KWB3/stm32-nrf24-transmitter/transmitter.jpeg

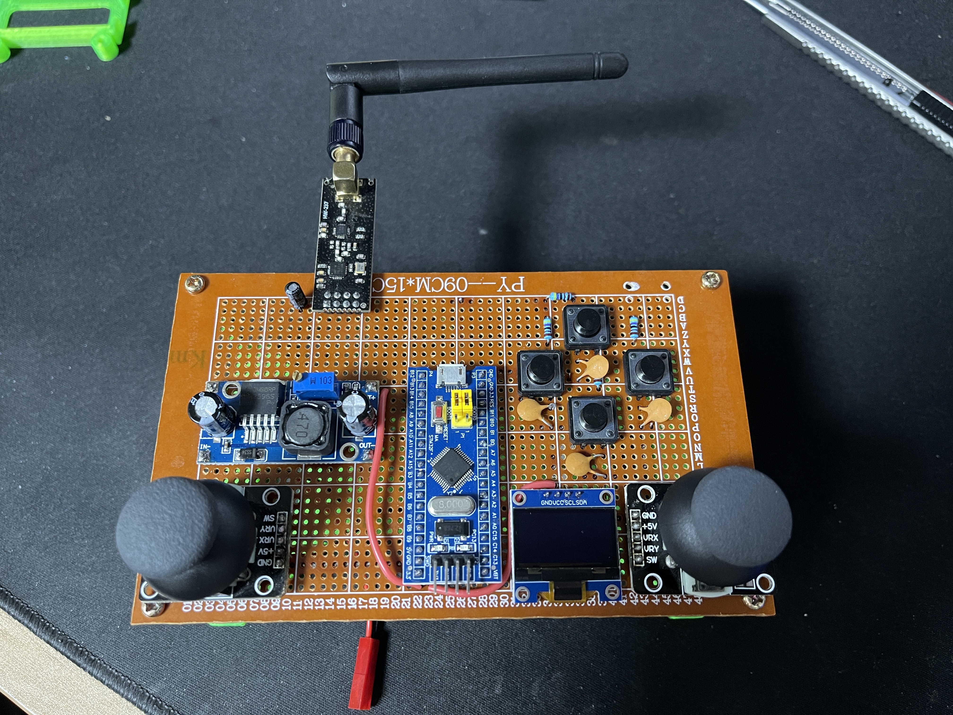
transmitter.jpeg
