KWB3/stm32-nrf24-transmitter/stl files/supporter_M3_50mm.stl

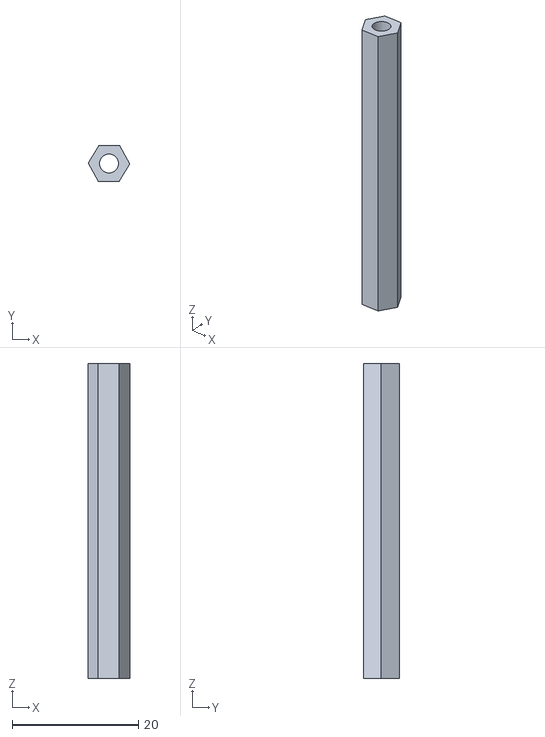
[picture p3: CAD file, 2025-11-06]
stl files/supporter_M3_50mm.stl
6.60 x 5.78 x 50.0
