KWB3/stm32-nrf24-transmitter/stl files/joy_pcb_holder.stl

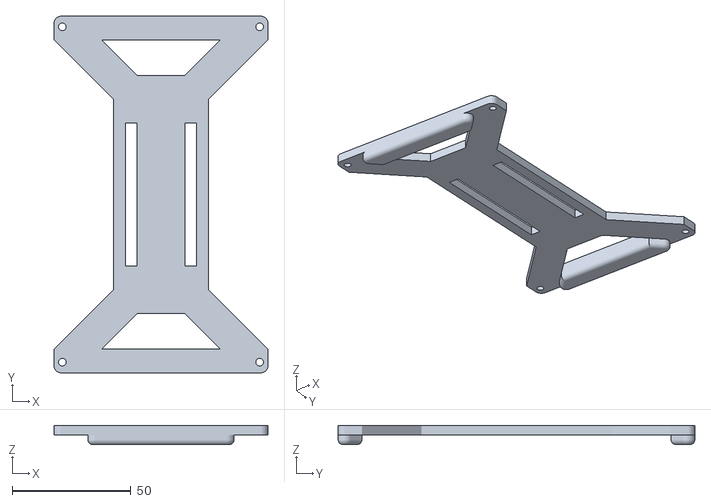
[picture p4: CAD file, 2025-11-06]
stl files/joy_pcb_holder.stl
90.0 x 150.0 x 8.00
