KWB3/stm32-nrf24-transmitter/Schematic.pdf

LM2596 Module | JOYSTICK Module 1

## JOYSTICK Module 2

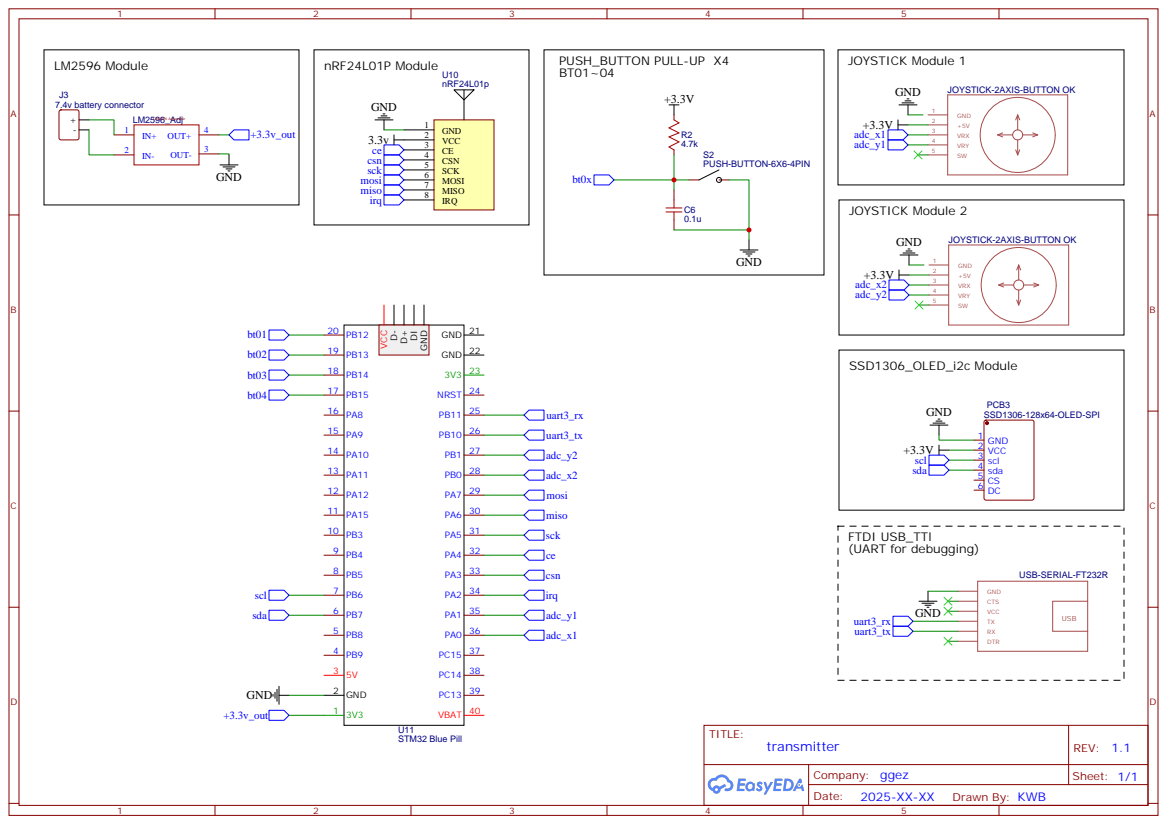
[picture p5: page 1]
