KWB3/stm32-nrf24-transmitter/transmitter/transmitter.ioc

Mcu.UserName=STM32F103C8Tx
PA0-WKUP.Signal=ADCx_IN0
PA1.Signal=ADCx_IN1
PA13.Signal=SYS_JTMS-SWDIO
PA14.Signal=SYS_JTCK-SWCLK
PA2.GPIO_Label=IRQ
PA2.Signal=GPXTI2
PA3.GPIO_Label=CSN
PA3.Signal=GPIO_Output
PA4.GPIO_Label=CE
PA4.Signal=GPIO_Output
PA5.Signal=SPI1_SCK
PA6.Signal=SPI1_MISO
PA7.Signal=SPI1_MOSI
PB0.Signal=ADCx_IN8
PB1.Signal=ADCx_IN9
PB10.Signal=USART3_TX
PB11.Signal=USART3_RX
PB12.GPIO_Label=bt1
PB12.Signal=GPIO_Input
PB13.GPIO_Label=bt2
PB13.Signal=GPIO_Input
PB14.GPIO_Label=bt3
PB14.Signal=GPIO_Input
PB15.GPIO_Label=bt4
PB15.Signal=GPIO_Input
PB6.Signal=I2C1_SCL
PB7.Signal=I2C1_SDA
PD0-OSC_IN.Signal=RCC_OSC_IN
PD1-OSC_OUT.Signal=RCC_OSC_OUT
