KWB3/stm32-nrf24-transmitter/transmitter/Core/Inc/main.h

#define IRQ_Pin GPIO_PIN_2
#define IRQ_GPIO_Port GPIOA
#define IRQ_EXTI_IRQn EXTI2_IRQn
#define CSN_Pin GPIO_PIN_3
#define CSN_GPIO_Port GPIOA
#define CE_Pin GPIO_PIN_4
#define CE_GPIO_Port GPIOA
#define bt1_Pin GPIO_PIN_12
#define bt1_GPIO_Port GPIOB
#define bt2_Pin GPIO_PIN_13
#define bt2_GPIO_Port GPIOB
#define bt3_Pin GPIO_PIN_14
#define bt3_GPIO_Port GPIOB
#define bt4_Pin GPIO_PIN_15
#define bt4_GPIO_Port GPIOB
