KWB3/stm32-nrf24-transmitter/(commit log)

2025-11-06 upload total file
    완성본 업로드
2025-11-06 add stl files
    add stl files
    [joy_pcb_holder.stl, supporter_M3_50mm.stl]
2025-11-07 Modify schematic file
    Modify schematic file
2025-12-01 Update main.c
    oled 전원 안정화를 위한 딜레이 추가 .
