KWB3/stm32-nrf24-transmitter/(notices)

Notices in the files:
transmitter/Core/Src/main.c:
Copyright (c) 2025 STMicroelectronics.
All rights reserved.
This software is licensed under terms that can be found in the LICENSE file
